airpocket-soundman/xiamocon/README.md

# xiamocon
Game Console-Shaped Motherboard for XIAO RP2350/ESP32S3
