airpocket-soundman/xiamocon/hardware/kicad/xiamocon.kicad_pcb

## KiCad design hardware/kicad/xiamocon.kicad_pcb (2026-03-16)

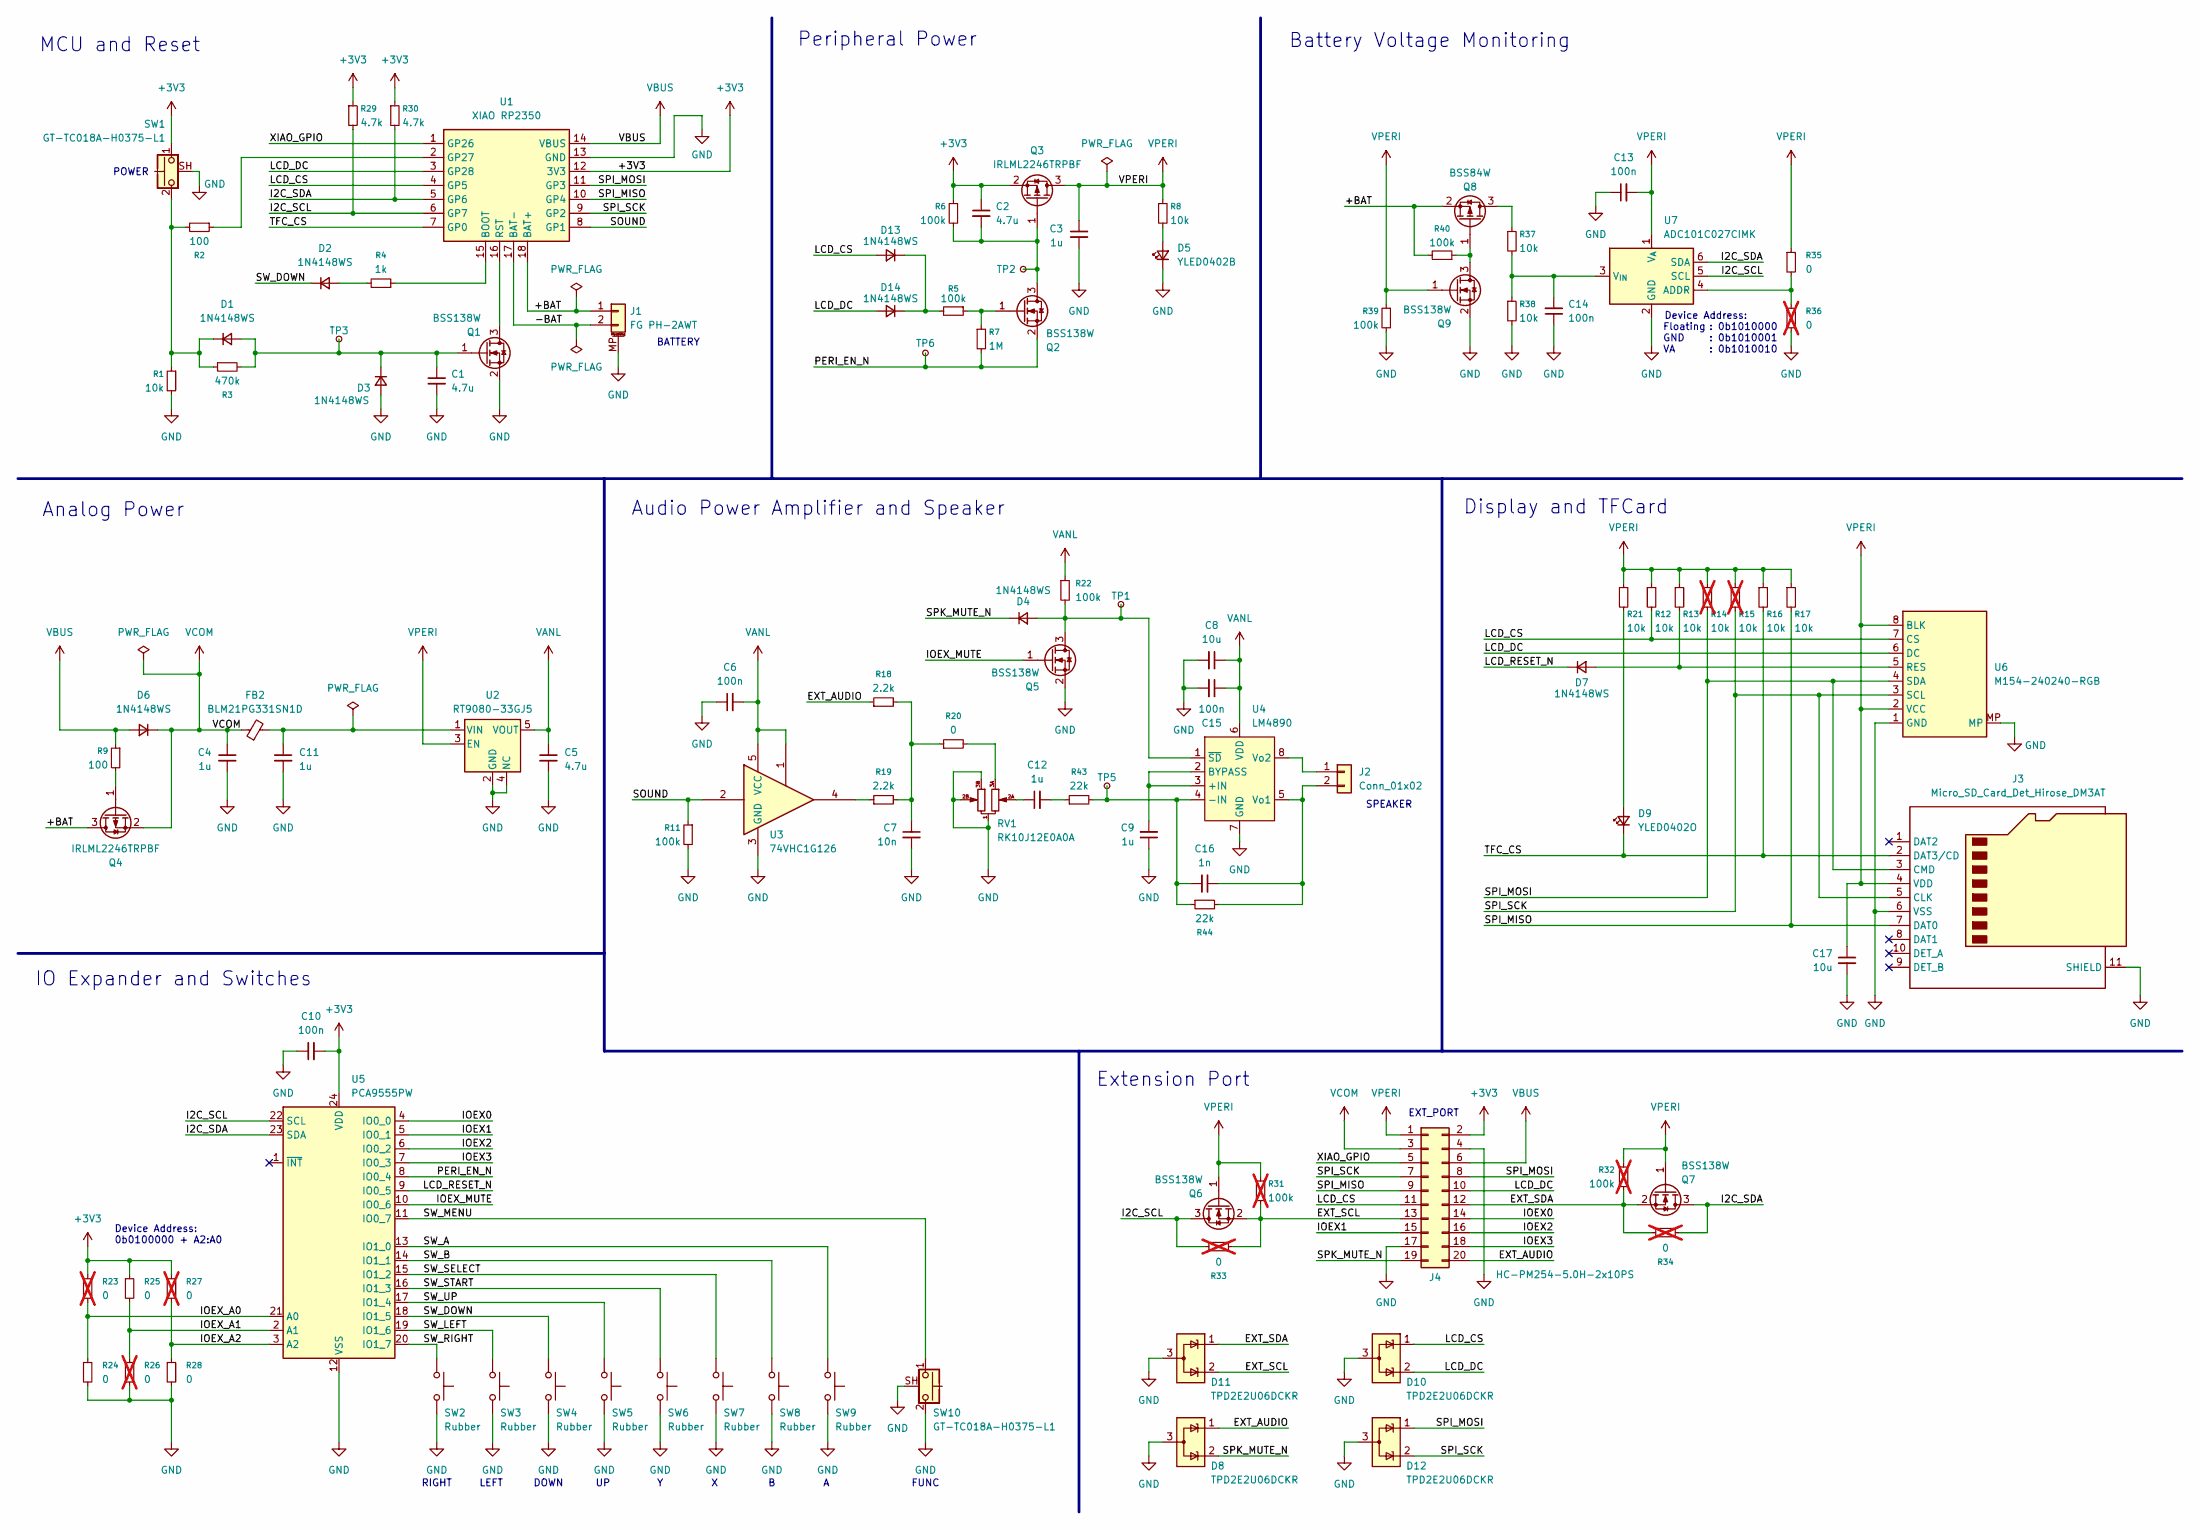
[picture p1: schematic xiamocon.kicad_sch]

Parts:
C1, C2, C5: 4.7u; C_0603_1608Metric; LCSC C19666
C3, C4, C11: 1u; C_0402_1005Metric; LCSC C52923
C6, C10, C13, C14, C15: 100n; C_0402_1005Metric; LCSC C1525
C7: 10n; C_0402_1005Metric; LCSC C15195
C8, C17: 10u; C_0603_1608Metric; LCSC C1691
C9, C12: 1u; C_0603_1608Metric; LCSC C15849
C16: 1n; C_0402_1005Metric; LCSC C1523
D1, D2, D3, D4, D7, D13, D14: 1N4148WS; D_SOD-523; LCSC C917006
D5: YLED0402B; LED_0402_1005Metric_Pad0.77x0.64mm_HandSolder; LCSC C30584803
D6: 1N4148WS; D_SOD-323; LCSC C2128
D8, D10, D11, D12: TPD2E2U06DCKR; SOT-323_SC-70; LCSC C1855726
D9: YLED0402O; LED_0402_1005Metric_Pad0.77x0.64mm_HandSolder; LCSC C28310436
FB2: BLM21PG331SN1D; L_0805_2012Metric; LCSC C74764
J1: FG PH-2AWT; JST_PH_S2B-PH-SM4-TB_1x02-1MP_P2.00mm_Horizontal; LCSC C2763693
J2: Conn_01x02; SolderWirePad_1x02_SMD_150x50mil
J3: Micro_SD_Card_Det_Hirose_DM3AT; microSD_HC_Hirose_DM3AT-SF-PEJM5; LCSC C114218
J4: HC-PM254-5.0H-2x10PS; PinSocket_2x10_P2.54mm_Vertical_SMD; LCSC C42163138
Q1, Q2, Q5, Q6, Q7, Q9: BSS138W; SOT-323_SC-70; LCSC C504052
Q3, Q4: IRLML2246TRPBF; SOT-23; LCSC C127272
Q8: BSS84W; SOT-323_SC-70; LCSC C919394
R1, R12, R13, R16, R17, R37, R38: 10k; R_0402_1005Metric; LCSC C25744
R2, R9: 100; R_0402_1005Metric; LCSC C25076
R3: 470k; R_0402_1005Metric; LCSC C137976
R4: 1k; R_0402_1005Metric; LCSC C11702
R5, R6, R11, R22, R39, R40: 100k; R_0402_1005Metric; LCSC C25741
R7: 1M; R_0402_1005Metric; LCSC C26083
R8, R21: 10k; R_0402_1005Metric_Pad0.72x0.64mm_HandSolder; LCSC C25744
R14, R15: 10k; R_0402_1005Metric; LCSC C25744; not fitted
R18, R19: 2.2k; R_0402_1005Metric; LCSC C25879
R20, R24, R25, R28, R35: 0; R_0402_1005Metric; LCSC C17168
R23, R26, R27, R33, R34, R36: 0; R_0402_1005Metric; LCSC C17168; not fitted
R29, R30: 4.7k; R_0402_1005Metric; LCSC C25900
R31, R32: 100k; R_0402_1005Metric; LCSC C25741; not fitted
R43, R44: 22k; R_0402_1005Metric; LCSC C25768
RV1: RK10J12E0A0A; RK10J1xE; LCSC C351176
SW1, SW10: GT-TC018A-H0375-L1; LCSC C963235
SW2, SW3, SW4, SW5, SW6, SW7, SW8, SW9: Rubber; Rubber_Contact
TP1, TP2, TP3, TP5, TP6: PWAMP_CE; TestPoint_Pad_D1.5mm
U1: XIAO RP2350
U2: RT9080-33GJ5; TSOT-23-5; LCSC C841192
U3: 74VHC1G126; SOT-23-5; LCSC C53100485
U4: LM4890; MSOP-8_3x3mm_P0.65mm; LCSC C329452
U5: PCA9555PW; TSSOP-24_4.4x7.8mm_P0.65mm; LCSC C128392
U6: M154-240240-RGB
U7: ADC101C027CIMK; TSOT-23-6; LCSC C701590

Connections:
+3V3: C2.1, C10.2, J4.2, Q3.2 (S), R6.1, R23.1, R25.1, R27.1, R29.1, R30.1, SW1.1, U1.12 (3V3), U5.24 (VDD)
/+BAT: J1.1, Q4.3 (D), Q8.2 (S), R40.2, U1.18 (BAT+)
/-BAT: J1.2, U1.17 (BAT-)
/EXT_AUDIO: D8.1 (K), J4.20, R18.1
/EXT_SCL: D11.2 (K), J4.13, Q6.2 (S), R31.2, R33.2
/EXT_SDA: D11.1 (K), J4.12, Q7.2 (S), R32.2, R34.1
/I2C_SCL: Q6.3 (D), R29.2, R33.1, U1.6 (GP7), U5.22 (SCL), U7.5 (SCL)
/I2C_SDA: Q7.3 (D), R30.2, R34.2, U1.5 (GP6), U5.23 (SDA), U7.6 (SDA)
/IOEX0: J4.14, U5.4 (IO0_0)
/IOEX1: J4.15, U5.5 (IO0_1)
/IOEX2: J4.16, U5.6 (IO0_2)
/IOEX3: J4.18, U5.7 (IO0_3)
/IOEX_A0: R23.2, R24.1, U5.21 (A0)
/IOEX_A1: R25.2, R26.1, U5.2 (A1)
/IOEX_A2: R27.2, R28.1, U5.3 (A2)
/IOEX_MUTE: Q5.1 (G), U5.10 (IO0_6)
/LCD_CS: D10.1 (K), D13.2 (A), J4.11, R12.2, U1.4 (GP5), U6.7 (CS)
/LCD_DC: D10.2 (K), D14.2 (A), J4.10, U1.3 (GP28), U6.6 (DC)
/LCD_RESET_N: D7.1 (K), U5.9 (IO0_5)
/PERI_EN_N: Q2.2 (S), R7.2, TP6.1, U5.8 (IO0_4)
/SOUND: R11.1, U1.8 (GP1), U3.2
/SPI_MISO: J3.7 (DAT0), J4.9, R17.2, U1.10 (GP4)
/SPI_MOSI: D12.1 (K), J3.3 (CMD), J4.8, R14.2, U1.11 (GP3), U6.4 (SDA)
/SPI_SCK: D12.2 (K), J3.5 (CLK), J4.7, R15.2, U1.9 (GP2), U6.3 (SCL)
/SPK_MUTE_N: D4.1 (K), D8.2 (K), J4.19
/SW_A: SW9.1, U5.13 (IO1_0)
/SW_B: SW8.1, U5.14 (IO1_1)
/SW_DOWN: D2.1 (K), SW4.1, U5.18 (IO1_5)
/SW_LEFT: SW3.1, U5.19 (IO1_6)
/SW_MENU: SW10.1, U5.11 (IO0_7)
/SW_RIGHT: SW2.1, U5.20 (IO1_7)
/SW_SELECT: SW7.1, U5.15 (IO1_2)
/SW_START: SW6.1, U5.16 (IO1_3)
/SW_UP: SW5.1, U5.17 (IO1_4)
/TFC_CS: D9.1 (K), J3.2 (DAT3/CD), R16.2, U1.7 (GP0)
/XIAO_GPIO: J4.5, U1.1 (GP26)
GND: C1.2, C3.2, C4.2, C5.2, C6.1, C7.2, C8.2, C9.1, C10.1, C11.2, C13.1, C14.1, C15.2, C17.2, D3.2 (A), D5.1 (K), D8.3 (A), D10.3 (A), D11.3 (A), D12.3 (A), J1.MP (MountPin), J3.6 (VSS), J3.11 (SHIELD), J4.4, J4.17, Q1.2 (S), Q5.2 (S), Q9.2 (S), R1.2, R11.2, R24.2, R26.2, R28.2, R36.2, R38.2, R39.2, RV1.1, RV1.2B, RV1.3B, SW1.SH (B), SW2.2, SW3.2, SW4.2, SW5.2, SW6.2, SW7.2, SW8.2, SW9.2, SW10.2, SW10.SH (B), U1.13 (GND), U2.2 (GND), U2.4 (NC), U3.3 (GND), U4.7 (GND), U5.12 (VSS), U6.1 (GND), U6.MP, U7.2 (GND)
unnamed: C7.1, R18.2, R19.2, R20.1
unnamed: C12.1, RV1.2A
unnamed: C12.2, R43.1
unnamed: C1.1, D1.2 (A), D3.1 (K), Q1.1 (G), R3.2, TP3.1
unnamed: D1.1 (K), R1.1, R2.2, R3.1, SW1.2
unnamed: D2.2 (A), R4.2
unnamed: D4.2 (A), Q5.3 (D), R22.2, TP1.1, U4.1 (~SD)
unnamed: D5.2 (A), R8.2
unnamed: D7.2 (A), R13.2, U6.5 (RES)
unnamed: D9.2 (A), R21.2
unnamed: D13.1 (K), D14.1 (K), R5.2
unnamed: J2.1, U4.8 (Vo2)
unnamed: C16.1, J2.2, R44.2, U4.5 (Vo1)
unnamed: Q1.3 (D), U1.16 (RST)
unnamed: C2.2, Q2.3 (D), Q3.1 (G), R6.2, TP2.1
unnamed: Q2.1 (G), R5.1, R7.1
unnamed: Q4.1 (G), R9.2
unnamed: Q8.3 (D), R37.1
unnamed: Q8.1 (G), Q9.3 (D), R40.1
unnamed: R19.1, U3.4
unnamed: R20.2, RV1.3A
unnamed: R4.1, U1.15 (BOOT)
unnamed: R2.1, U1.2 (GP27)
unnamed: C11.1, FB2.2, U2.1 (VIN)
unnamed: C9.2, U4.2 (BYPASS), U4.3 (+IN)
unnamed: C16.2, R43.2, R44.1, TP5.1, U4.4 (-IN)
unnamed: R35.2, R36.1, U7.4 (ADDR)
unnamed: C14.2, R37.2, R38.1, U7.3 (V_{IN})
VANL: C5.1, C6.2, C8.1, C15.1, R22.1, U2.5 (VOUT), U3.1, U3.5 (VCC), U4.6 (VDD)
VBUS: D6.2 (A), J4.6, R9.1, U1.14 (VBUS)
VCOM: C4.1, D6.1 (K), FB2.1, J4.3, Q4.2 (S)
VPERI: C3.1, C13.2, C17.1, J3.4 (VDD), J4.1, Q3.3 (D), Q6.1 (G), Q7.1 (G), Q9.1 (G), R8.1, R12.1, R13.1, R14.1, R15.1, R16.1, R17.1, R21.1, R31.1, R32.1, R35.1, R39.1, U2.3 (EN), U6.2 (VCC), U6.8 (BLK), U7.1 (V_{A})

Notes on the sheet:
LEFT
BATTERY
Display and TFCard
Audio Power Amplifier and Speaker
DOWN
Device Address:
Extension Port
RIGHT
Floating GND VA
SPEAKER
Peripheral Power
Device Address: 0b0100000 + A2:A0
Battery Voltage Monitoring
MCU and Reset
EXT_PORT
POWER
IO Expander and Switches
: 0b1010000 : 0b1010001 : 0b1010010
FUNC
Analog Power

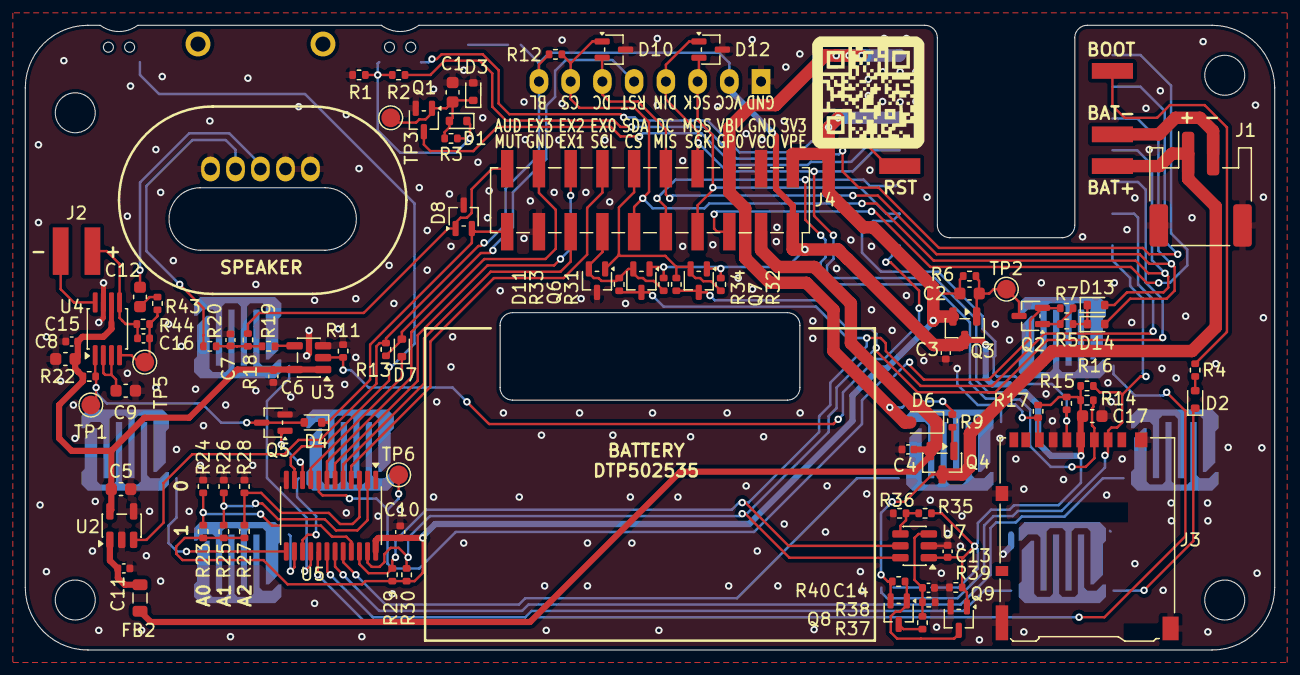
[picture p2: board xiamocon.kicad_pcb from above]

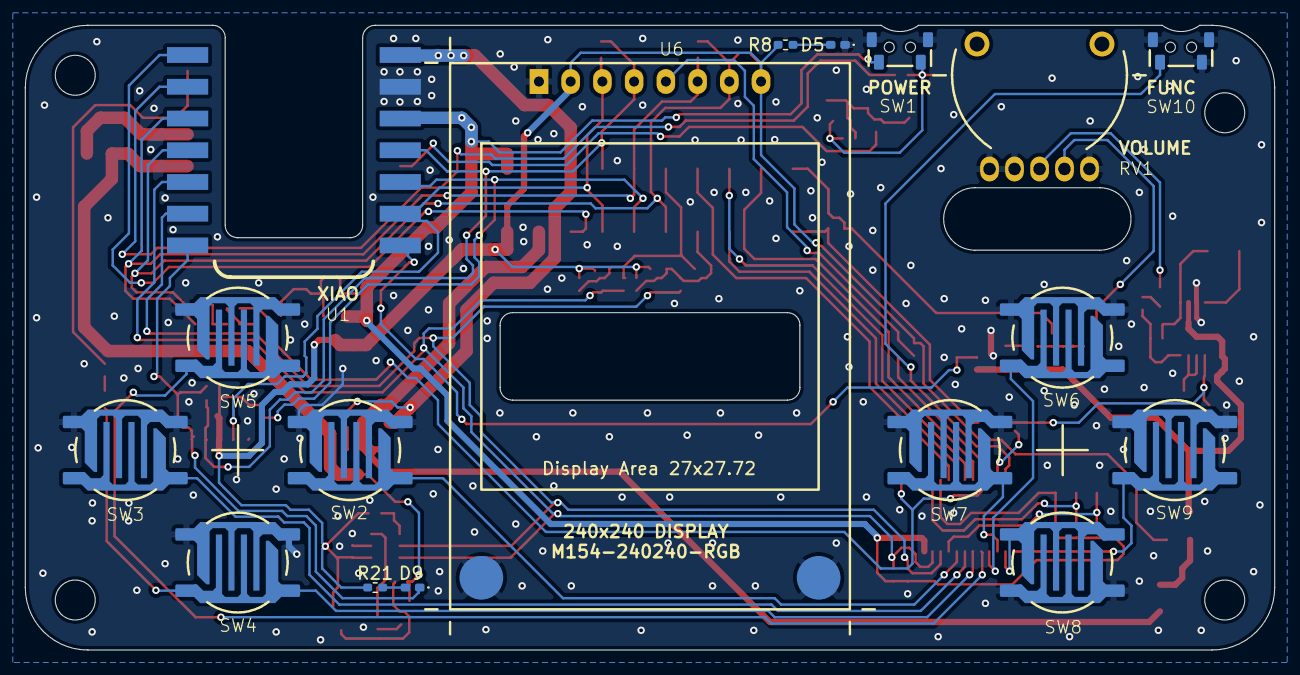
[picture p3: board xiamocon.kicad_pcb from below]

Board: 2 copper layers, 100.0 x 50.0 mm, 109 parts (17 on the bottom side), 69 nets.
