airpocket-soundman/xiamocon/cpp/platform/impl/rp2350_pico_sdk/src/main.cpp

#include "xmc/app_entry.hpp"

#include <hardware/clocks.h>
#include <hardware/vreg.h>
#include <pico/stdlib.h>

static const uint32_t SYS_CLK_FREQ = 250000000;

int main() {
#if 1
  vreg_set_voltage(VREG_VOLTAGE_1_30);
  sleep_ms(100);
  set_sys_clock_khz(SYS_CLK_FREQ / 1000, true);
  clock_configure(clk_peri, 0, CLOCKS_CLK_PERI_CTRL_AUXSRC_VALUE_CLKSRC_PLL_SYS,
                  SYS_CLK_FREQ, SYS_CLK_FREQ);
#endif
  xmc::appMain();
  return 0;
}
