airpocket-soundman/xiamocon/cpp/platform/impl/atoms3_pio_arduino/src/pins.cpp

#include "xmc/hw/pins.hpp"

// AtomS3 pin definitions
const int XMC_PIN_I2C_SDA = 38;
const int XMC_PIN_I2C_SCL = 39;
const int XMC_PIN_SPI_MOSI = 21;
const int XMC_PIN_SPI_MISO = -1;  // Display is write-only
const int XMC_PIN_SPI_SCK = 17;
const int XMC_PIN_DISPLAY_CS = 15;
const int XMC_PIN_DISPLAY_DC = 33;
const int XMC_PIN_TFCARD_CS = -1;
const int XMC_PIN_AUDIO_OUT = -1;
const int XMC_PIN_POWER_BUTTON = -1;
const int XMC_PIN_GPIO_0 = -1;
