airpocket-soundman/xiamocon/cpp/example/imu_demo/include/bmp_earth.hpp

#pragma once

#include <stdint.h>

// 256x128px, RGBA4444
// B:G:R:A, Little Endian, Horizontal Adressing
// 65536 Bytes
const uint8_t bmp_earth_data[] = {
  0xde, 0xfd, 0xde, 0xfd, 0xdd, 0xfd, 0xde, 0xfd, 0xde, 0xfd, 0xde, 0xfd, 0xdd, 0xfd, 0xce, 0xfd,
  0xde, 0xfd, 0xde, 0xfd, 0xde, 0xfd, 0xde, 0xfd, 0xde, 0xfd, 0xde, 0xfd, 0xde, 0xfd, 0xde, 0xfe,
  0xde, 0xfd, 0xee, 0xfe, 0xde, 0xfd, 0xee, 0xfe, 0xde, 0xfd, 0xde, 0xfd, 0xde, 0xfd, 0xde, 0xfd,
  0xde, 0xfd, 0xde, 0xfd, 0xde, 0xfd, 0xde, 0xfd, 0xde, 0xfd, 0xde, 0xfd, 0xde, 0xfe, 0xee, 0xfd,
  0xee, 0xfe, 0xdf, 0xfe, 0xee, 0xfe, 0xef, 0xfe, 0xef, 0xfe, 0xee, 0xfe, 0xde, 0xfd, 0xde, 0xfe,
  0xde, 0xfd, 0xde, 0xfd, 0xde, 0xfd, 0xde, 0xfd, 0xde, 0xfd, 0xde, 0xfd, 0xde, 0xfd, 0xde, 0xfd,
  0xde, 0xfd, 0xde, 0xfd, 0xde, 0xfd, 0xde, 0xfd, 0xde, 0xfd, 0xde, 0xfd, 0xde, 0xfd, 0xde, 0xfd,
  0xde, 0xfd, 0xde, 0xfd, 0xde, 0xfd, 0xde, 0xfd, 0xde, 0xfd, 0xde, 0xfd, 0xde, 0xfd, 0xde, 0xfd,
  0xde, 0xfd, 0xde, 0xfd, 0xde, 0xfd, 0xde, 0xfd, 0xde, 0xfd, 0xde, 0xfd, 0xde, 0xfd, 0xde, 0xfd,
  0xde, 0xfd, 0xde, 0xfd, 0xde, 0xfd, 0xde, 0xfd, 0xde, 0xfd, 0xde, 0xfd, 0xde, 0xfd, 0xde, 0xfd,
  0xde, 0xfe, 0xde, 0xfd, 0xde, 0xfd, 0xde, 0xfd, 0xde, 0xfd, 0xde, 0xfd, 0xde, 0xfd, 0xde, 0xfd,
  0xde, 0xfd, 0xde, 0xfd, 0xde, 0xfd, 0xde, 0xfd, 0xde, 0xfd, 0xde, 0xfe, 0xde, 0xfd, 0xde, 0xfd,
  0xde, 0xfd, 0xde, 0xfd, 0xde, 0xfd, 0xde, 0xfd, 0xde, 0xfd, 0xee, 0xfe, 0xde, 0xfd, 0xde, 0xfd,
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
  0xdd, 0xfd, 0xdd, 0xfd, 0xde, 0xfe, 0xdd, 0xfd, 0xdd, 0xfd, 0xdd, 0xfd, 0xdd, 0xfd, 0xdd, 0xfd,
  0xdd, 0xfd, 0xdd, 0xfd, 0xdd, 0xfd, 0xcd, 0xfd, 0xdd, 0xfd, 0xdd, 0xfd, 0xdd, 0xfd, 0xdd, 0xfd,
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
};
