airpocket-soundman/xiamocon/(commit log)

2026-03-12 schematic fixed
    [xiamocon.kicad_sch]
2026-03-16 pcb rev2 checked
    [xiamocon.kicad_pcb, xiamocon.kicad_sch]
2026-03-16 pcb rev.2 ordered
    [xiamocon.kicad_pcb, xiamocon.kicad_sch]
2026-03-26 AtomS3用デモ制作中
